tobiasslethei/flame_logger/data/experiment_log.csv

timestamp | position | tc_temp | internal_temp
824395 | 1500 | 944.75 | 22.62
824504 | 1499 | 942.5 | 22.62
824612 | 1498 | 943.75 | 22.62
824719 | 1497 | 940.5 | 22.62
824828 | 1496 | 940.5 | 22.62
824935 | 1495 | 940.75 | 22.62
825043 | 1494 | 938.75 | 22.62
825152 | 1493 | 940.0 | 22.62
825259 | 1492 | 937.75 | 22.62
825368 | 1491 | 937.5 | 22.56
825476 | 1490 | 936.25 | 22.62
825583 | 1489 | 935.0 | 22.62
825692 | 1488 | 933.75 | 22.56
825800 | 1487 | 933.75 | 22.56
825908 | 1486 | 933.0 | 22.62
826015 | 1485 | 932.25 | 22.62
826122 | 1484 | 931.0 | 22.62
826230 | 1483 | 929.75 | 22.62
826337 | 1482 | 928.75 | 22.62
826446 | 1481 | 929.5 | 22.56
826553 | 1480 | 927.0 | 22.56
826661 | 1479 | 928.0 | 22.62
826769 | 1478 | 929.5 | 22.56
826877 | 1477 | 932.5 | 22.62
826986 | 1476 | 937.0 | 22.62
827094 | 1475 | 938.5 | 22.62
827201 | 1474 | 945.5 | 22.62
827309 | 1473 | 949.25 | 22.62
827418 | 1472 | 951.5 | 22.62
827526 | 1471 | 953.25 | 22.56
827633 | 1470 | 950.75 | 22.62
827741 | 1469 | 950.75 | 22.62
827850 | 1468 | 950.0 | 22.62
827957 | 1467 | 948.75 | 22.56
828067 | 1466 | 949.0 | 22.62
828176 | 1465 | 948.5 | 22.62
828284 | 1464 | 949.75 | 22.62
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
